PardalisTres/Lebenszeitablauf/README.md

# Lebenszeitablauf

## Ziel

Gewünscht ist ein Sekundenzähler, der allerdings ab einer vorgegebenen Zahl
(z.B. 30 Jahre) abwärts zählt.

Angezeigt werden sollen die verbleibenden Sekunden mittels LED-Ziffern
(7-Segment-Anzeige).

--------------------------------------------------------------------------------

# Entwicklungstagebuch

## 7-Segment-Anzeige

Für 30 Jahre werden bereits neun Ziffern benötigt;
die gängigen fertigen Lösungen bieten höchstens acht
(die dann allerdings bereits mit einem eigenen Controller einfach angesteuert werden können).

Gefunden habe ich letztlich eine Lösung mit fünf Ziffern,
sodass zwei davon für die geforderte Aufgabe ausreichen sollten.

### Ansteuerung eines 5-Ziffern-Bauteils

Jeder dieser 5-Ziffern-Bausteine hat allerdings bereits 13 Verbindungspunkte,
die alle benötigt werden;
somit ergeben sich bei zwei dieser Bausteine 26 benötigte Pins.
(Ein üblicher ESP32 hat 25 GPIO-Pins, also genau einen zu wenig.)

Lösungsmöglichkeiten:
- Pins sparen: Da die Punkte der 7-Segment-Anzeige (also das jeweils achte Segment)
  nicht benötigt werden, genügen pro Baustein 12 Verbindungen.
  Da die Aufgabe mit einem Arduino Nano mit 20 GPIO-Pins gelöst werden soll, sind dies allerdings immer noch zu viele.
  (Es wäre aber ein interessanter Zwischenschritt auf dem Weg zur endgültigen Lösung.)
- IO-Expander: Die Anzahl der nutzbaren Pins kann via Baustein erhöht werden.
- Eigenen Mikrocontroller pro 5-Ziffern-Anzeige programmieren und die beiden dann ansteuern.
  (Dies könnte die interessanteste Vorgehensweise sein - allerdings auch die hardware-aufwendigste.)

### Anzeigen fünf verschiedener Ziffern pro Bauteil

Die vorgegebene Verdrahtung lässt bei konstantem Strom auf allen fünf Ziffern
nur die gleiche Anzeige erscheinen
(oder gar keine, wenn der Ausgang der Ziffer nicht geschaltet ist).

Die Ansteuerung muss also im millisekunden-gesteuerten Wechsel erfolgen.

Auch abhängig von der gewählten Lösung des Anschlusses der beiden Bausteine ist
die Taktung des Wechsels zwischen den Ziffern:
Kann jede Ziffer bei einem Fünftel oder einem Zehntel der Zeit angesteuert werden?

## Test 1: Fünfstellige Zahlen anzeigen

Ein erstes kleines Testprogramm soll die Darstellung
beliebiger fünfstelliger Zahlen in einem Anzeigebauteil ermöglichen.

### Probleme

Im ersten Versuch will die Arduino IDE mich weder Funktionen mit std::bitset als Parameter
definieren lassen noch mir einen vernünftigen seriellen Output anzeigen.
Zudem wird die fünfte Ziffer nicht mit angezeigt.

Zum zweiten Punkt habe ich den Verdacht, dass eventuell einer der benutzten Pins
mit zum Serial gehört;
zum dritten, dass eventuell eine Verkabelung nicht stimmt.

Für einen Abend war das aber erst einmal genug angesammelter Frust
und es geht wann anders weiter.

### Lösungen

Die Lösung für das fehlgeschlagene include ist, die Präcompiler-Anweisung direkt
in die erste Datei einzufügen.
Beim Zusammenkopieren der Sketches mit Vorwegnahme der Funktionsdeklarationen
kommt es ansonsten zu diesen Fehlern.

Die beiden anderen Punkte lagen tatsächlich an der Verkabelung:
Einerseits hatte ich RX0 und TX0 als Funktions-Pins verwendet
und mir damit selbst den seriellen Monitor verbaut,
andererseits hatte ich nicht berücksichtigt, dass einige GPIO-Pins
nur für den INPUT verwendet werden können.

### Erfreuliches

Das Anzeigen fünf verschiedener Ziffern gleichzeitig hat dafür direkt im
ersten Versuch funktioniert - ein freudiger Hoffnungsschimmer.

## Lötungen

FÜr den nächsten Test benötige ich einen IO-Expander,
in diesem Fall will ich es mit einem PCF8575 versuchen.
Diesen muss ich aber erst einmal mit seinen Steckleisten verlöten,
um ihn ordentlich testen zu können.
Es folgen die Bilder meiner ersten ganz eigenen Lötung.

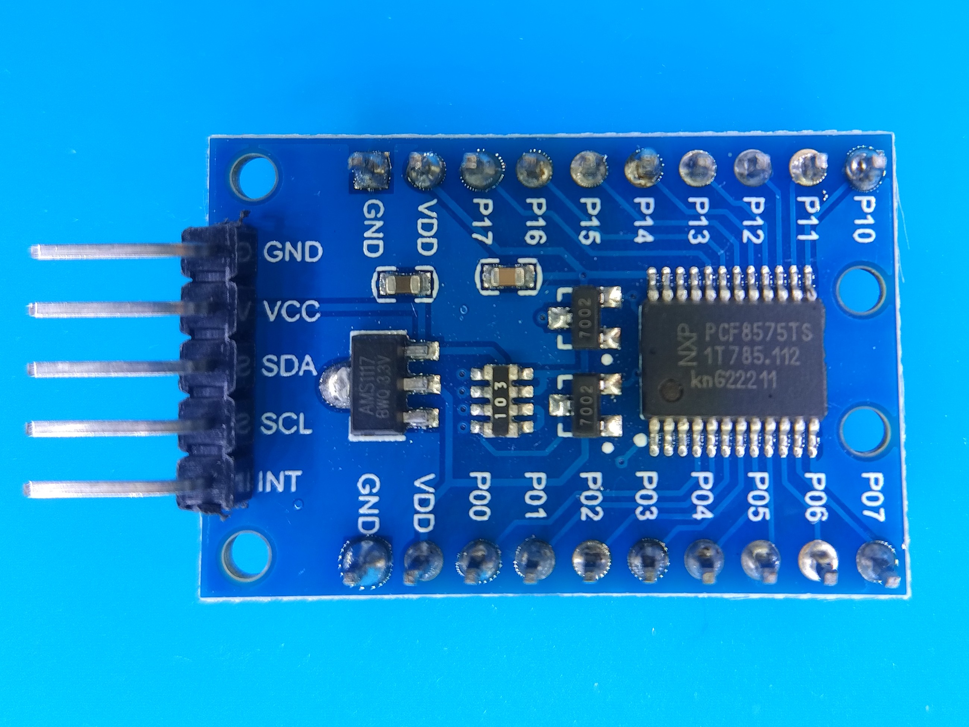
[picture p1: Fotos/loet_multiplexer_1.jpg]

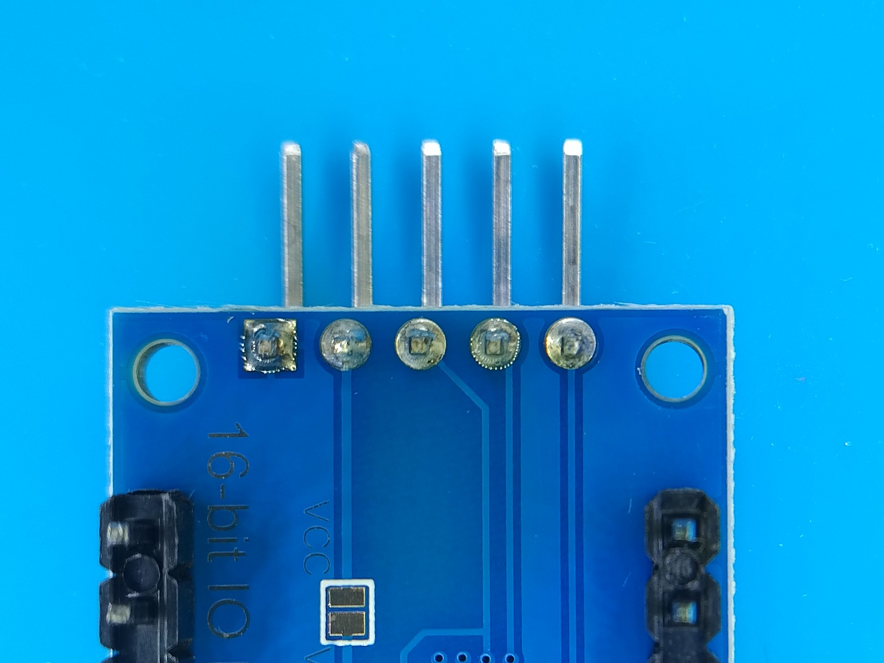
[picture p2: Fotos/loet_multiplexer_2.jpg]

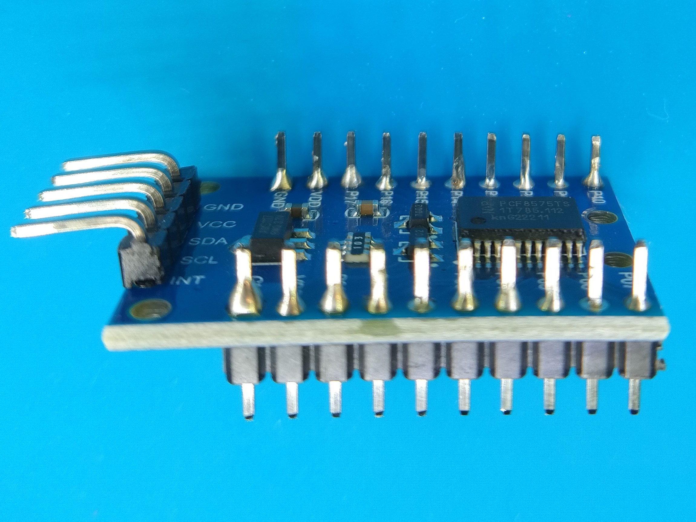
[picture p3: Fotos/loet_multiplexer_3.jpg]


Wenn das jetzt auch noch funktioniert damit, bin ich doch ganz zufrieden -
obgleich der alte Lötkolben (oder das Lötzinn) sich doch etwas gewöhnungsbedürftig verhalten hat.

## Test 2: Der IO-Expander

Beim Verkabeln des IO-Expanders mit einer fünfstelligen 7-Segment-Anzeige
kommt mir ein mögliches Problem in den Kopf:
Kann der Expander auch OUTPUT-Pins schalten?

Dies wäre wichtig, um die fünf Ausgänge der Anzeige durchschalten zu können.
Andernfalls müssten die Ausgänge doch direkt an den Mikrocontroller geführt werden.
Immerhin könnte man jeweils zwei Ausgänge (jeweils eine der beiden fünfstellen Anzeigen) gleichzeitig ansteuern,
sofern man dann auch ihre Anzeige-Daten entsprechend synchronisiert.

Das werden die Tests dann als nächstes zeigen.

Hinweis: Ob sich notfalls wohl mit Kondensatoren arbeiten lässt,
falls die LEDs bei zu vielen gleichzeitig anzuzeigenden Ziffern nicht hell genug leuchten?

### Neue Probleme

Die ersten Versuche waren erst einmal nicht allzu vielversprechend:
Weder ließen sich gezielt Segmente der Ziffern anschalten,
noch einzelne Ziffern auswählen.

Ein Verbinden eines Ziffern-Ausgangs mit dem Gnd-Port des Expanders
eröffnete die Anzeige dieser Ziffer - jedoch wie erwähnt lediglich
aller Segmente, nicht gezielter.

Womöglich ist es zielführender, wenn ich den Expander erst einmal mit einer simpleren
LED-Sammlung teste.

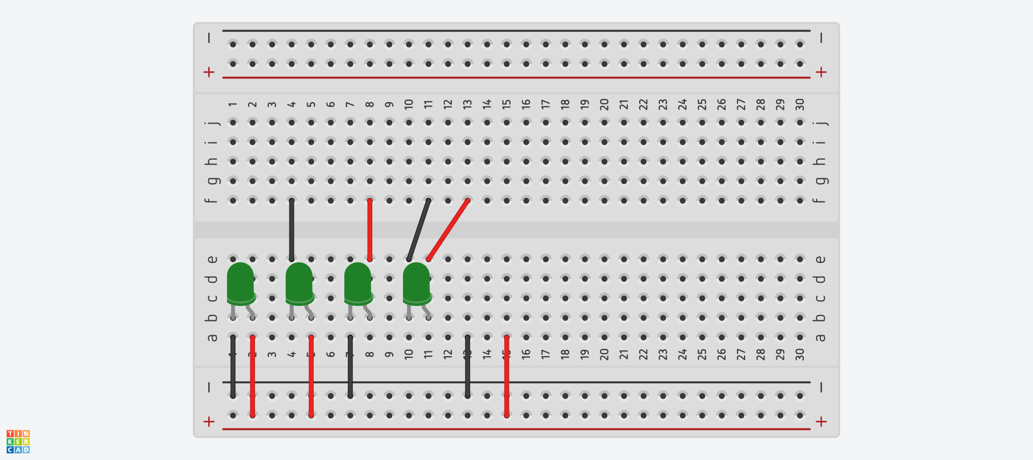
[picture p4: test_expanderXleds/ExpanderTestLed.png]


Die ersten Versuche brachten hier leider allesamt keine zufriedenstellenden
Erkenntnisse.

### Lösungsidee

Ein anderer Lösungsansatz wäre das Verwenden der Pins direkt am
Mikrocontroller als schaltbare Ausgänge - da das Senden von Daten an
die Pins des Expanders als Ausgabe zu funktionieren scheint
(wie die ersten Tests mit Expander und Segment gezeigt hatten).

Hierbei könnte dann die Ausgänge des jeweils n-ten Segments der
beiden 5x7-Segment-Anzeigen gleichzeitig gesetzt werden,
wenn dabei darauf geachtet wird, ihnen beiden im gleichen Moment
die jeweiligen Eingabedaten für die darzustellende Ziffer mitzugeben.

## Test 3: Expander und Display-Blöcke

Im ersten Versuch (beide Anzeigeblöcke zeigen gleichzeitig,
ihre Stellen nach und nach durchlaufend,
die Wertigkeit dieser Stelle (in beiden Blöcken gleich).

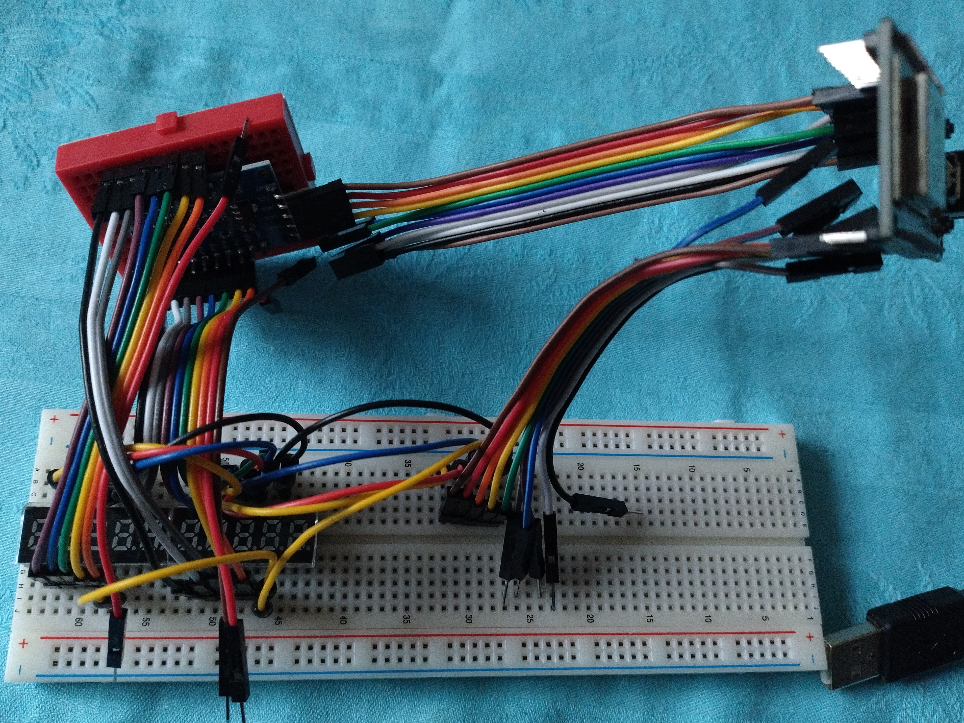
[picture p5: Fotos/verkabelung_1.jpg]

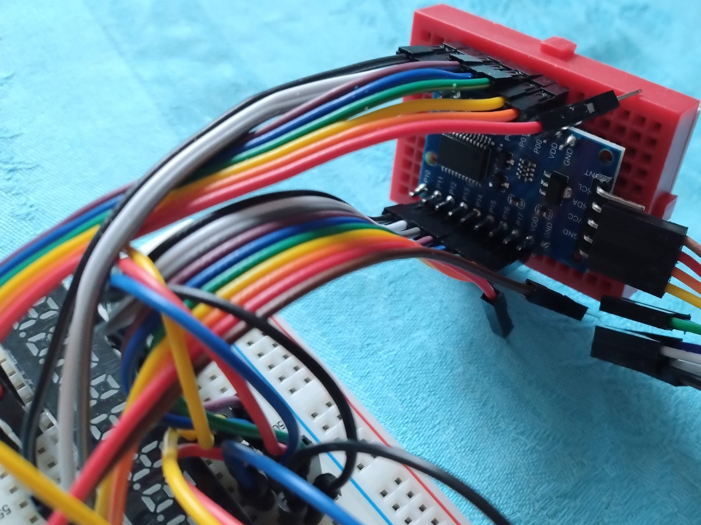
[picture p6: Fotos/verkabelung_2.jpg]


Dabei treten drei Probleme auf:
- Die Ziffern 4 und 5 werden nicht dargestellt.
- Segment C wird beim zweiten Block nicht dargestellt.
- Ansonsten werden alle Segmente dargestellt, nicht nur ausgewählte.

Das erste Problem kam mir vom anderen Test bekannt vor,
und siehe da: ja, ich habe wieder einen Input-Only-GPIO-Pin
des Controllers verkabelt, der das gewünschte nicht leisten kann;
dies lässt sich also leicht beheben.

Das zweite Problem lag ebenfalls an der Verkabelung,
bzw. daran, dass der Expander nicht fest genug in seinem
Klemmbrett steckte.

Fehlt also nur noch die Antwort auf die Frage
(die bereits den letzten Test zu keinem positiven Ergebnis führte),
warum der Expander anscheinend alle Pins gleichzeitig
mit Ausgabestrom beliefert.

### Bibliotheksersetzung

Über ihre eigene Umsetzung des Expanders schreiben die Leute von Adafruit
auf [dieser Seite](https://learn.adafruit.com/adafruit-pcf8575),
dass eine LED nicht so einfach über den Expander zu beleuchten sei -
also genau wie es auch bei mir nicht funktionieren will.

Sie sagen dabei auch, dass man sich darüber keine Gedanken machen solle,
da ihre Bibliothek dies faken kann.
Somit ist mein nächster Ansatz klar:
Ich versuche es mal mit der Adafruit-Bibliothek für den Expander.

### Geistesblitz

Beim Umschreiben auf den Adafruit-Expander fällt mir dabei auf,
dass ich die I2C-Pins, die ich als Konstanten anlege,
nirgends verwendet habe...
Wie soll denn so auch die Kommunikation über diesen Bus funktionieren?!

Pinzipiell sicherlich ein sehr guter Auffall - aber leider
hier nicht zielführend:
Nach dem Setzen der richtigen Pins an das Wire-Objekt
bleiben alle Segmente dunkel.
Dann doch lieber das falsche, aber sichtbare Durchlaufen
der bepunkteten Achten...

Und weiter geht es doch mit dem Versuch des Bibliothekentauschs.
Das Setzen der I2C-Pins sollte ich aber für die vorherigen Tests
noch einmal ausprobieren.

### Großer Schritt vorwärts

Mit der Adafruit-Bibliothek läuft es prinzipiell!

Zwar werden noch falsche Bitmuster angezeigt, aber dies lässt sich
sicherlich schnell herausfinden und korrigieren, in welcher
Reihenfolge hier die Segmente angegeben werden sollen.

Interessant wäre dann noch, einen gemischten Modus auszuprobieren,
der von der Bibliothek auch unterstützt werden soll.
(Und herauszufinden, wie das Ganze funktioniert - immerhin müsste
es dann theoretisch auch mit der Bibliothek von Tillaart
zu programmieren gehen.
Aber mal schauen, ob meine Motivation mal so weit reichen wird,
da weiter nachzuforschen, wenn der Rest erst einmal läuft.)

### Verkabelungsprobleme?

Da teilweise auf den beiden Blöcken unterschiedliche Bitmuster
angezeigt werden, und nicht einmal die 8 vollständig angezeigt
wird, vermute ich ein Problem bei der Verkabelung
(oder bei der Nennung der Pins im Code).

Eigentlich ein guter Anreiz, erst einmal zu den vorherigen,
einfacheren Tests zurückzukehren.

## Nachgeholter Testerfolg

Et voilà: Der Test mit den LEDs hinter dem Expander funktioniert.
