PardalisTres/Lebenszeitablauf/Schaltungen/README.md

# Schaltungen

Die Schaltpläne wurden angelegt mit [SimulIDE](https://simulide.com/p/).

## Schaltplan einer fünfstelligen 7-Segment-Anzeige

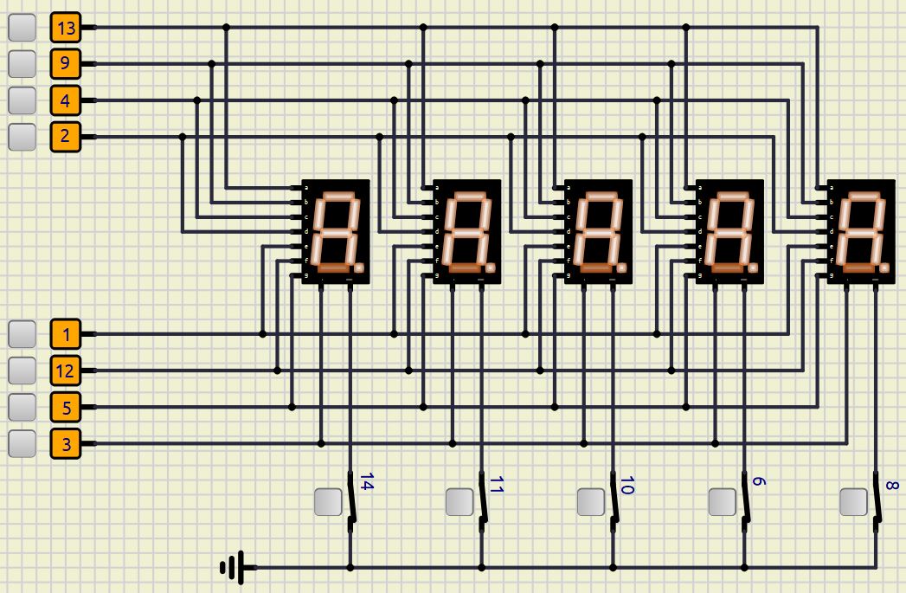
[picture p7: Schaltungen/5x7Segment.jpg]
