PardalisTres/Lebenszeitablauf/(list of files, drawings)

Other design files:
Schaltungen/5x7Segment.sim1
