PardalisTres/Lebenszeitablauf/(commit log)

2024-02-27 Schaltplan für ein Segment
    [5x7Segment.sim1]
2024-03-02 Pin-Belegung korrigiert
2024-03-12 Erste Tests mit Expander und LEDs
2024-03-13 Bilder der Vollverkabelung
2024-03-13 Korrektur des Expander+Anzeige-Tests
2024-03-13 Erster Versuch mit der Adafruit-Bibliothek
2024-03-15 LED-Test korrigiert und zum Erfolg geführt
    [test_expanderXanzeige.ino, test_expanderXleds.ino]
